pms67/STM32F1-Breakout-Board/SimpleTM32.kicad_pcb

## KiCad design SimpleTM32.kicad_pcb (2020-11-21)

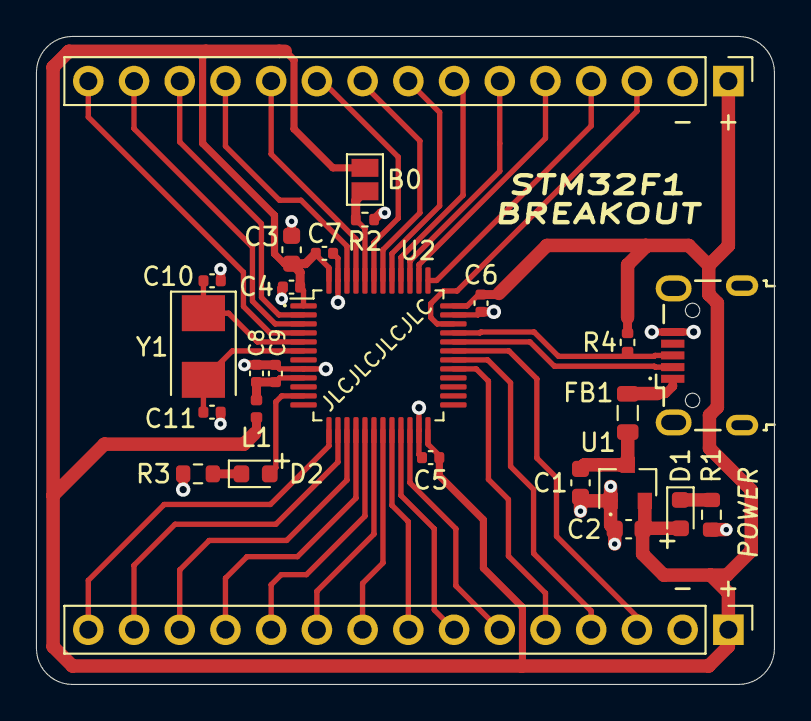
[picture p1: board SimpleTM32.kicad_pcb from above]

Board: 2 copper layers, 41.0 x 36.0 mm, 26 parts (0 on the bottom side), 39 nets.

Parts:
C1, C2: 1u; C_0603_1608Metric
C3: 4u7; C_0603_1608Metric
C4, C5, C6, C7, C9: 100n; C_0402_1005Metric
C8: 1u; C_0402_1005Metric
C10, C11: 30p; C_0402_1005Metric
D1: GREEN; LED_0603_1608Metric
D2: BLUE; LED_0603_1608Metric
FB1: 100R; L_0805_2012Metric
J1: USB_B_Micro; USB_Micro-B_Wuerth_629105150521
J2, J3: Conn_01x15; PinHeader_1x15_P2.54mm_Vertical
JP1: SolderJumper_2_Open; SolderJumper-2_P1.3mm_Open_Pad1.0x1.5mm
L1: 27n; L_0402_1005Metric
R1, R3: 1k5; R_0603_1608Metric
R2: 10k; R_0402_1005Metric
R4: 1k5; R_0402_1005Metric
U1: XC6206P332MR; SOT-23
U2: STM32F103C8T6; LQFP-48_7x7mm_P0.5mm
Y1: 8MHz; Crystal_SMD_5032-2Pin_5.0x3.2mm

Connections:
+3.3VA: C8.1, C9.1, L1.2, U2.9
+3V3: C2.1, C3.1, C4.1, C5.1, C6.1, C7.1, D1.2, J2.1, J3.1, JP1.1, L1.1, R4.1, U1.2, U2.1, U2.24, U2.36, U2.48
+5V: FB1.2, J1.1
/BOOT0: JP1.2, R2.1, U2.44
/HSE_IN: C11.1, U2.6, Y1.2
/HSE_OUT: C10.1, U2.5, Y1.1
/LED_STAT: D2.2, U2.11
GND: C1.2, C2.2, C3.2, C4.2, C5.2, C6.2, C7.2, C8.2, C9.2, C10.2, C11.2, J1.5, J2.2, J3.2, R1.2, R2.2, R3.2, U1.1, U2.8, U2.23, U2.35, U2.47
unnamed: D1.1, R1.1
unnamed: D2.1, R3.1
PA3: J3.15, U2.13
PA4: J3.14, U2.14
PA5: J3.13, U2.15
PA6: J3.12, U2.16
PA7: J3.11, U2.17
PA8: J3.5, U2.29
PA9: J3.4, U2.30
PA10: J3.3, U2.31
PA15: J2.5, U2.38
PB0: J3.10, U2.18
PB1: J3.9, U2.19
PB2: J3.8, U2.20
PB4: J2.7, U2.40
PB5: J2.8, U2.41
PB6: J2.9, U2.42
PB7: J2.10, U2.43
PB8: J2.11, U2.45
PB9: J2.12, U2.46
PB10: J3.7, U2.21
PB11: J3.6, U2.22
PC13: J2.13, U2.2
PC14: J2.14, U2.3
PC15: J2.15, U2.4
SWCLK: J2.4, U2.37
SWDIO: J2.3, U2.34
SWO: J2.6, U2.39
USB_D+: J1.3, R4.2, U2.33
USB_D-: J1.2, U2.32
VCC: C1.1, FB1.1, U1.3
