pms67/STM32F1-Breakout-Board/(threads)

Thread 3 (2025-07-15):

USB CDC will not work if board if powered from usb port alone

gigabitman, 2025-07-15:
Hello,

if you want to make serial COM over USB for example the board works fine as long as it is powered first by the st-link and then connected to PC with USB .
now if you power the board with usb port alone, the PC starts the handshake way before the stm32F1 even loaded, witch makes it error code 43 ( on windows ).
now the solution would be the disable the USB peripherals with something like this:

```

int main(void)
{

  /* USER CODE BEGIN 1 */

  /* USER CODE END 1 */

  /* MCU Configuration--------------------------------------------------------*/

  /* Reset of all peripherals, Initializes the Flash interface and the Systick. */
  HAL_Init();

  /* USER CODE BEGIN Init */

  /* USER CODE END Init */

  /* Configure the system clock */
  SystemClock_Config();

  /* USER CODE BEGIN SysInit */

  /* USER CODE END SysInit */

  /* Initialize all configured peripherals */
  MX_GPIO_Init();
  /* USER CODE BEGIN 2 */

  MX_USB_DEVICE_Init();
  HAL_Delay(5000);

  // Step 1: Completely stop and deinitialize USB
  USBD_Stop(&hUsbDeviceFS);
  USBD_DeInit(&hUsbDeviceFS);

  // Step 2: Reset USB peripheral completely
  __HAL_RCC_USB_FORCE_RESET();
  HAL_Delay(100);
  __HAL_RCC_USB_RELEASE_RESET();

  // Step 3: Disable USB clock
  __HAL_RCC_USB_CLK_DISABLE();
  HAL_Delay(100);

  // Step 4: Configure USB pins as analog to minimize interference
  GPIO_InitTypeDef GPIO_InitStruct = {0};
  __HAL_RCC_GPIOA_CLK_ENABLE();

  GPIO_InitStruct.Pin = GPIO_PIN_11 | GPIO_PIN_12;  // PA11=DM, PA12=DP
  GPIO_InitStruct.Mode = GPIO_MODE_ANALOG;          // Analog mode = high impedance
  GPIO_InitStruct.Pull = GPIO_NOPULL;
  HAL_GPIO_Init(GPIOA, &GPIO_InitStruct);

  // Step 5: Wait longer for host to timeout
  HAL_Delay(2000);  // Longer delay

  // Step 6: Re-enable everything
  __HAL_RCC_USB_CLK_ENABLE();
  HAL_Delay(100);

  // Step 7: Reinitialize USB
  MX_USB_DEVICE_Init();

```

but it wouldn't work since there is that R4 resistance there ?

disclaimer: I am new to PCB, and I hope that I am simply doing something wrong and simple solution is around the corner !
