pms67/STM32F1-Breakout-Board/(commit log)

2020-11-21 Initial commit.
    [629105150521.stp, SimpleTM32-BOM.csv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]
2020-12-05 Fixed empty schematic file.
    [SimpleTM32.sch]
